tianxiaopeng6666/stm32-/README.md

**项目名称：**
智慧大棚

**项目简介：**
通过二氧化碳传感器实时监测大棚内二氧化碳浓度，判断是否在最适宜大棚内农作物生长区间，通过继电器控制气肥补充；同时加入热释电红外传感器判断大棚内是否有人，降低二氧化碳浓度以免发生危险，最后将数据上传到阿里云，实现可视化。

**项目成员：**
