tianxiaopeng6666/stm32-/第四部分（程序）/注释代码/注释代码/readme.txt

### 适合硬件版本
- 底板：  MCU v1.0
- 传感板：sensor v1.0

### IDE软件
- MDK-ARM Professional 5.34
- 编译器： ARM_Complier_5.06
- ST标准库 V1.8.0 最终版

### 实现功能
- 读取空气中CO2含量和检测人体接近
- 控制继电器开关、风扇、蜂鸣器报警和OLED可视化结果
- 可上电可自动运行，也可以通过微信小程序、阿里云来手动控制继电器开关
