tianxiaopeng6666/stm32-/第四部分（程序）/esp8266程序/数据流转到表格存储.png

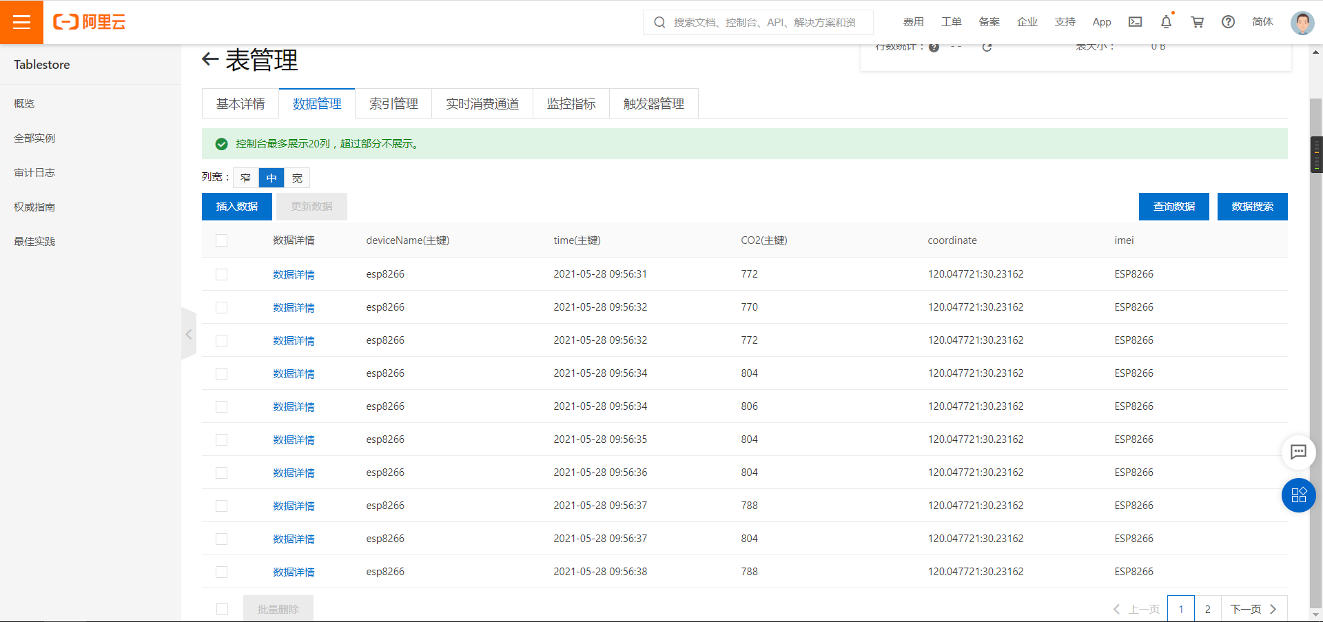
第四部分（程序）/esp8266程序/数据流转到表格存储.png
