tianxiaopeng6666/stm32-/第四部分（程序）/esp8266程序/数据流转规则引擎.png

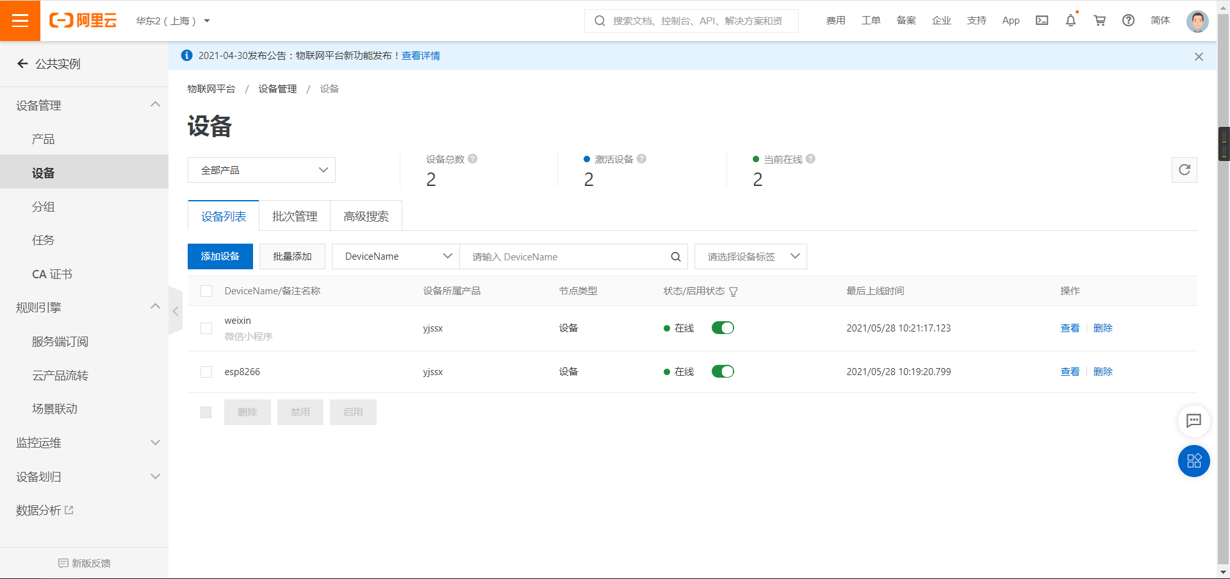
第四部分（程序）/esp8266程序/数据流转规则引擎.png
