tianxiaopeng6666/stm32-/第四部分（程序）/esp8266程序/阿里云ESP8266.png

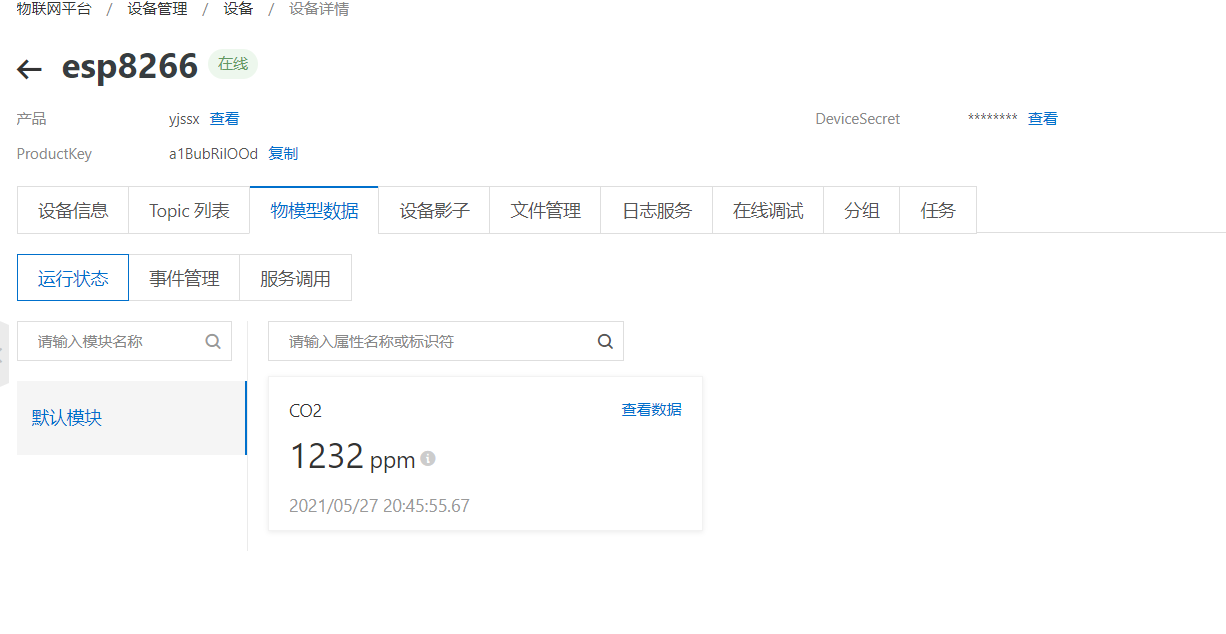
第四部分（程序）/esp8266程序/阿里云ESP8266.png
