tianxiaopeng6666/stm32-/第四部分（程序）/微信小程序图片.png

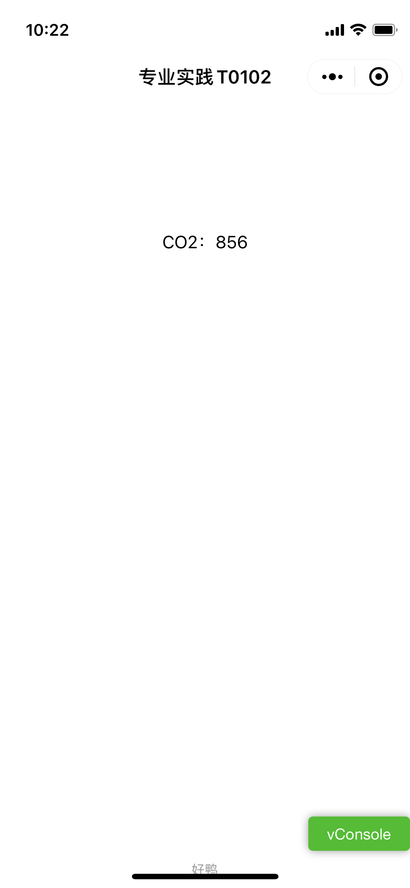
第四部分（程序）/微信小程序图片.png
