tianxiaopeng6666/stm32-/第四部分（程序）/阿里云控制继电器.png

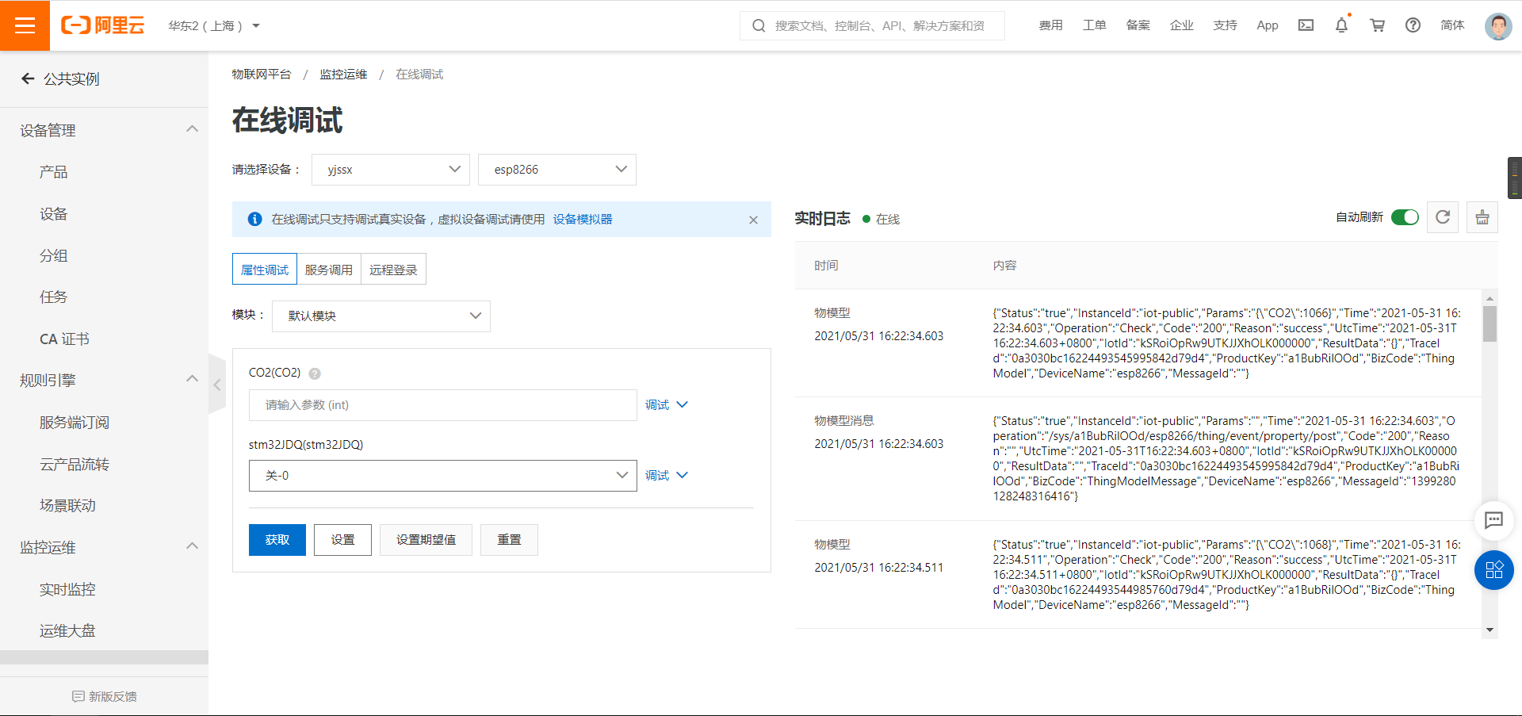
第四部分（程序）/阿里云控制继电器.png
