tianxiaopeng6666/stm32-/第三部分（焊接调试）/硬件调试/README.md

热释红外传感器：v1.0
输出：Voc在人体感应传感器前无人时输出电压为0V，有人时输出电压大于0V

电源模块：v1.0
输出：指示灯亮，万用表连GND与VCC3.3V时，万用表输出3.3V；万用表连GND与VCC5V时，万用表输出5V
