tianxiaopeng6666/stm32-/第三部分（焊接调试）/软件调试/README.md

OLED：V1.0
输出：OLED显示字体图案

蜂鸣器：v1.0
输出：蜂鸣器发出声音

最小系统：v1.0
输出：运行跑马灯程序、LED灯循环亮灭

继电器：v1.0
输出：间隔500ms连通

CO2:v1.0
输出：串口输出二氧化碳含量

热释红外传感器：v1.1
输出：烧入程序，热释红外传感器可通过串口输出是否有人
