tianxiaopeng6666/stm32-/第三部分（焊接调试）/软件调试/esp8266串口通信实验/readme.txt

ESP8266串口通讯实验
8266使用串口三 PD8 PD9  stm32接收串口三的数据
stm32通过串口七 PE7 PE8 将数据转发 
串口调试助手通过串口7可看到 esp8266通过串口三发送的数据
