tianxiaopeng6666/stm32-/第三部分（焊接调试）/软件调试/OLED IIC测试/readme.txt

//  功能描述   : Stm32f427 oled iic 测试程序
//              说明: 
//              ----------------------------------------------------------------
//              GND    电源地
//              VCC    接5V或3.3v电源
//              SCL    接PB10（SCL）
//              SDA    接PB11（SDA）
//              RES    PE14
//              ----------------------------------------------------------------
