tianxiaopeng6666/stm32-/第一部分（调试f411）/调试代码/实验3蜂鸣器实验/README.TXT

实验器材:
	NANO STM32FF4开发板V1版本
	
实验目的:
	进一步学习GPIO作为输出的使用
	
硬件资源:
	1,DS0(连接在PC0) 
	2,蜂鸣器(连接在PB8) 
	
实验现象:
	本实验通过代码控制开发板上的DS0和蜂鸣器，DS0闪烁，提示程序运行，而蜂鸣器
	则周期性的发出“嘀”的声音，间隔为0.3秒。 
	
注意事项:
	无.

					正点原子@ALIENTEK
					2019-3-15
					广州市星翼电子科技有限公司
					电话：020-38271790
					传真：020-36773971
					购买：http://shop62103354.taobao.com
					http://shop62057469.taobao.com
					公司网站：www.alientek.com
					技术论坛：www.openedv.com
