tianxiaopeng6666/stm32-/第三部分（焊接调试）/软件调试/CO2读取测试/readme.txt

CO2读取测试
PA2引脚
TIM5 第三通道
读取高电平时间除周期(1/1khz)为占空比
0-100% 占空比对应0-2000ppm
占空比*20即对应ppm
