tianxiaopeng6666/stm32-/第三部分（焊接调试）/软件调试/Flash_SPI读写测试/readme.txt

flash测试
SPI2
CS   PB12
SCK  PB13
MISO PB14
MOSI PB15
先向flash中写入字符串
然后读取flash串口打印
