tianxiaopeng6666/stm32-/第三部分（焊接调试）/软件调试/串口通信测试/readme.txt

串口调试
调试uart7
RX PE7
TX PE8

在串口监视器看到打印出字符串
