tianxiaopeng6666/stm32-/第三部分（焊接调试）/软件调试/蜂鸣器继电器测试/readme.txt

蜂鸣器 继电器 测试程序
蜂鸣器 PE15
继电器 PE12

蜂鸣器继电器间隔500ms工作
