tianxiaopeng6666/stm32-/第三部分（焊接调试）/硬件调试/晶振起振32.768khz.jpg

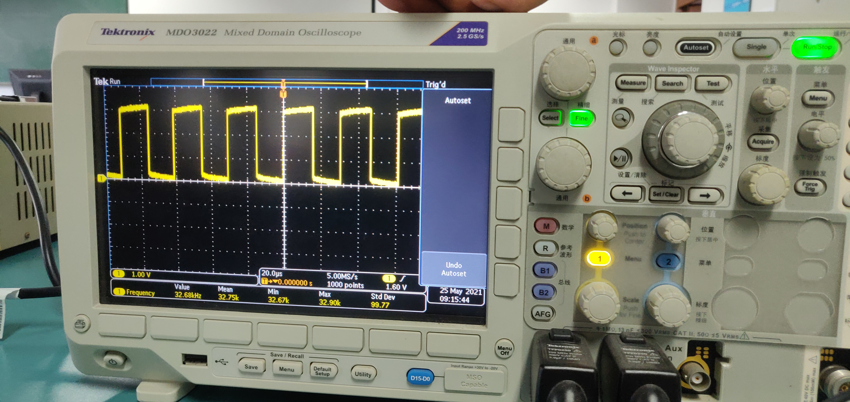
第三部分（焊接调试）/硬件调试/晶振起振32.768khz.jpg
