tianxiaopeng6666/stm32-/第三部分（焊接调试）/硬件调试/热释电红外传感器无人.jpg

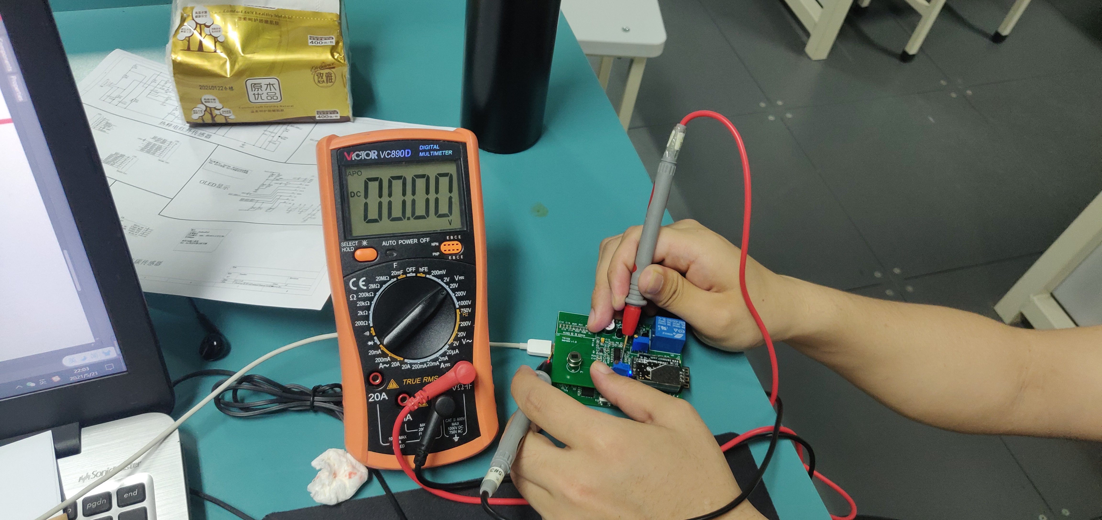
第三部分（焊接调试）/硬件调试/热释电红外传感器无人.jpg
