tianxiaopeng6666/stm32-/第三部分（焊接调试）/硬件调试/电源调试5V.jpg

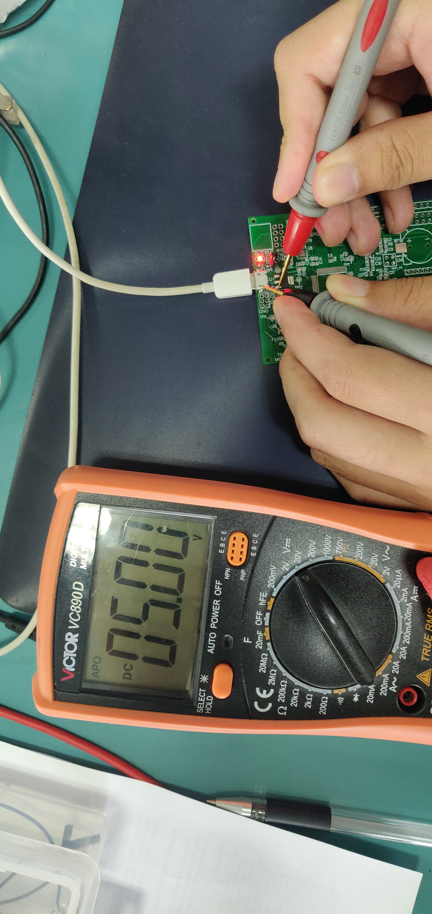
第三部分（焊接调试）/硬件调试/电源调试5V.jpg
