tianxiaopeng6666/stm32-/第三部分（焊接调试）/软件调试/CO2调试图片.jpg

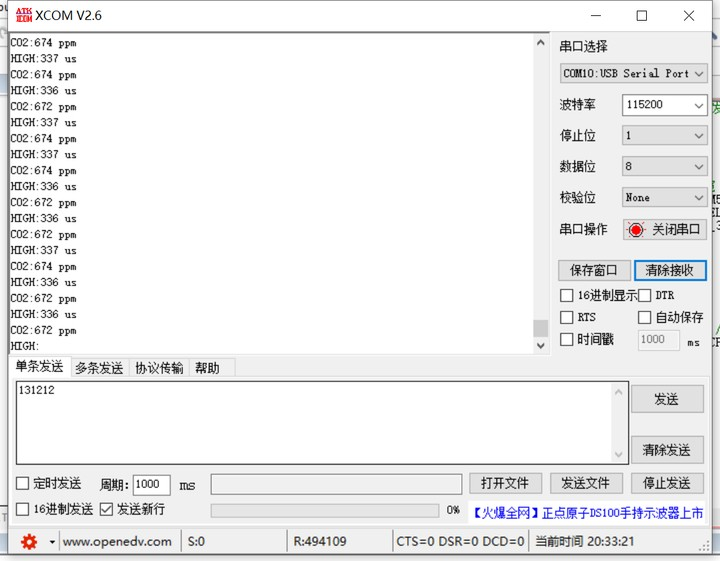
第三部分（焊接调试）/软件调试/CO2调试图片.jpg
