tianxiaopeng6666/stm32-/第三部分（焊接调试）/软件调试/DS3231测试.jpg

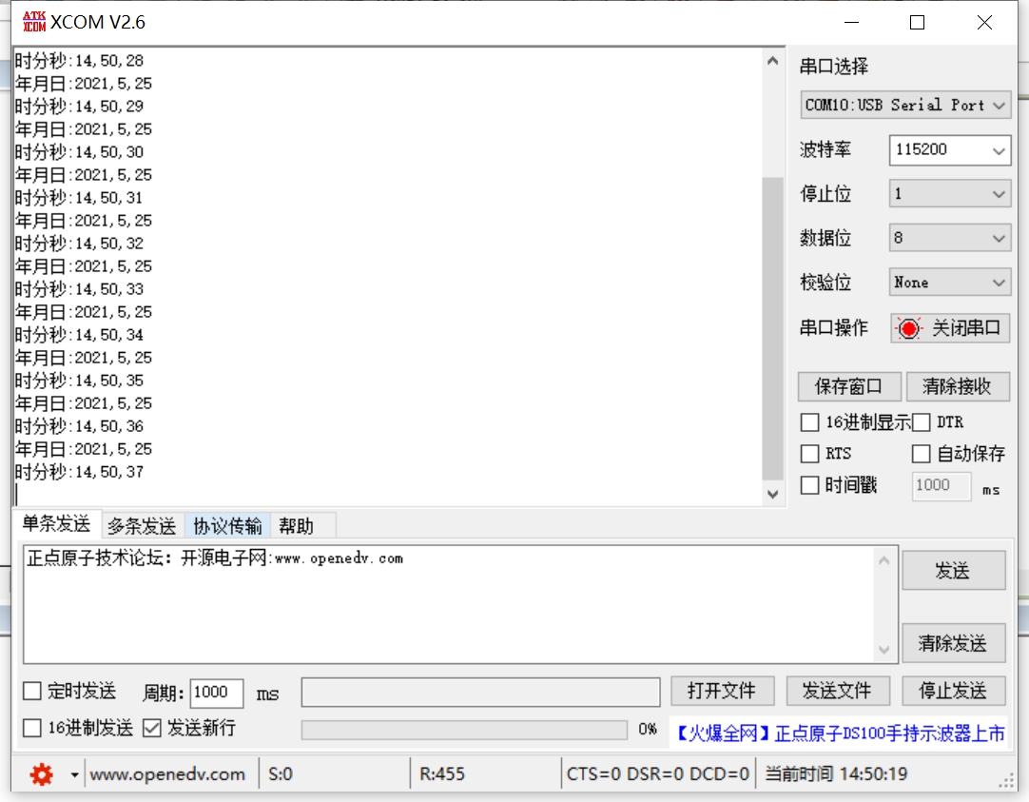
第三部分（焊接调试）/软件调试/DS3231测试.jpg
