tianxiaopeng6666/stm32-/第三部分（焊接调试）/软件调试/esp8266串口实验.png

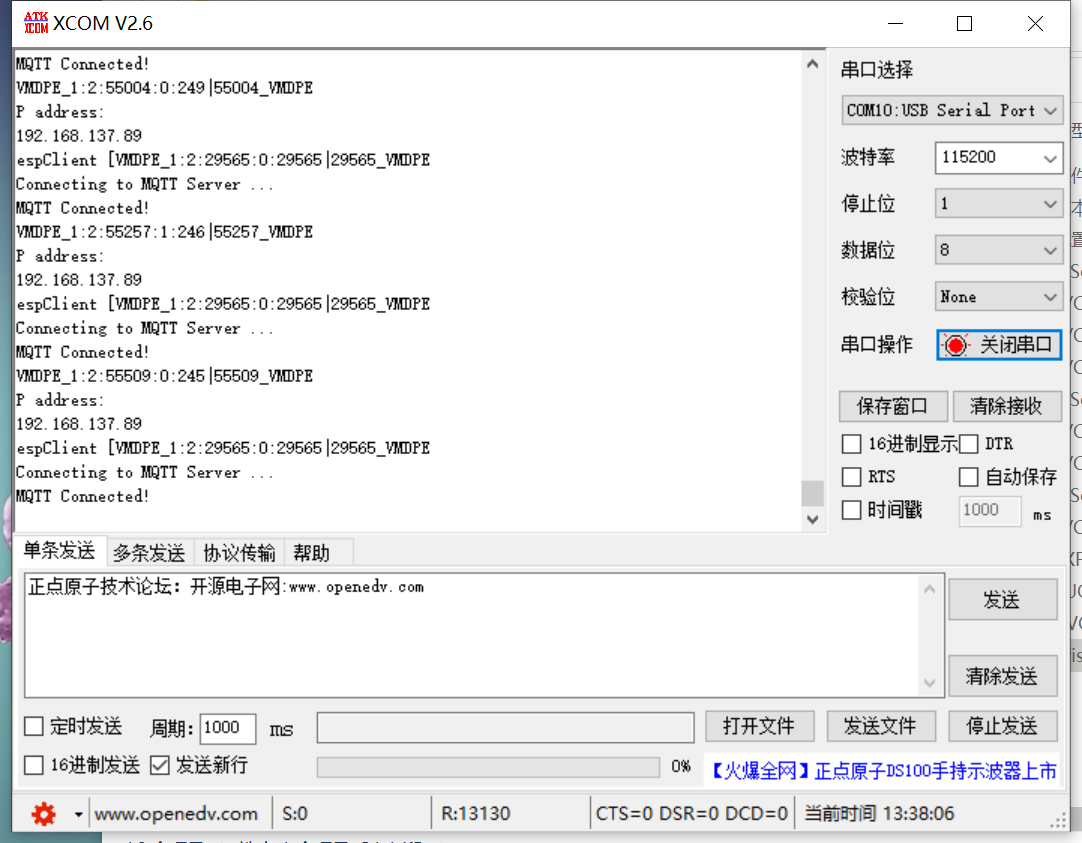
第三部分（焊接调试）/软件调试/esp8266串口实验.png
