tianxiaopeng6666/stm32-/第三部分（焊接调试）/软件调试/Flash_SPI读写测试.png

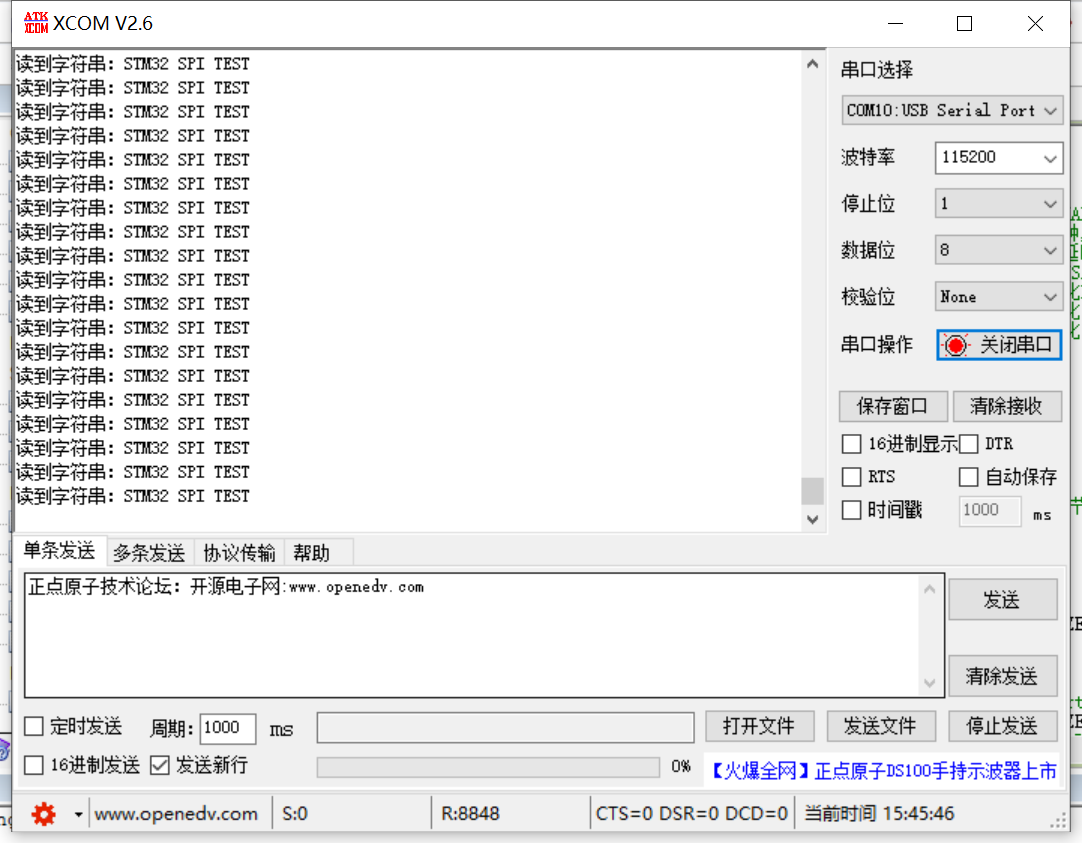
第三部分（焊接调试）/软件调试/Flash_SPI读写测试.png
