tianxiaopeng6666/stm32-/第三部分（焊接调试）/软件调试/OLED焊接的新底板F427上测试.jpg

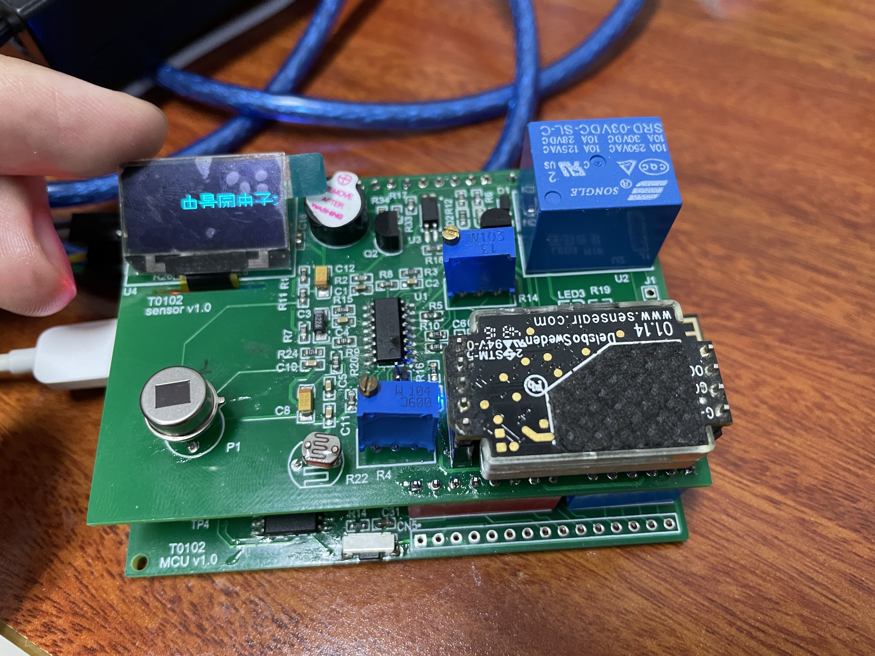
第三部分（焊接调试）/软件调试/OLED焊接的新底板F427上测试.jpg
