tianxiaopeng6666/stm32-/第三部分（焊接调试）/软件调试/串口测试.jpg

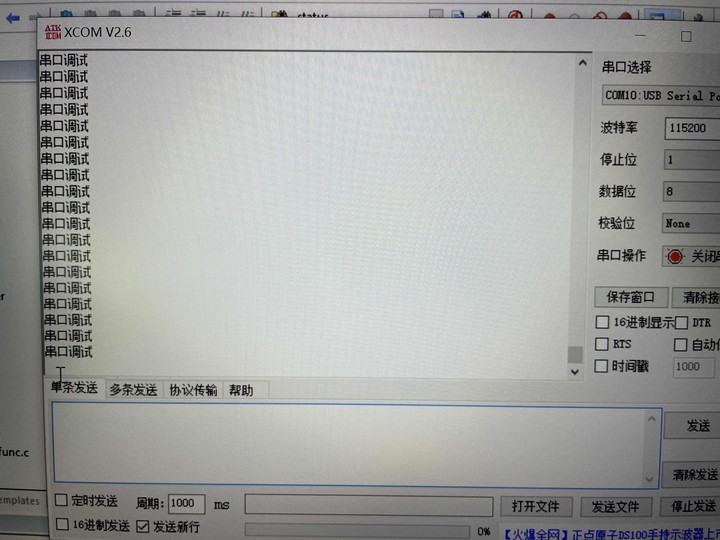
第三部分（焊接调试）/软件调试/串口测试.jpg
