tianxiaopeng6666/stm32-/第三部分（焊接调试）/软件调试/最小系统调试程序运行灯亮.jpg

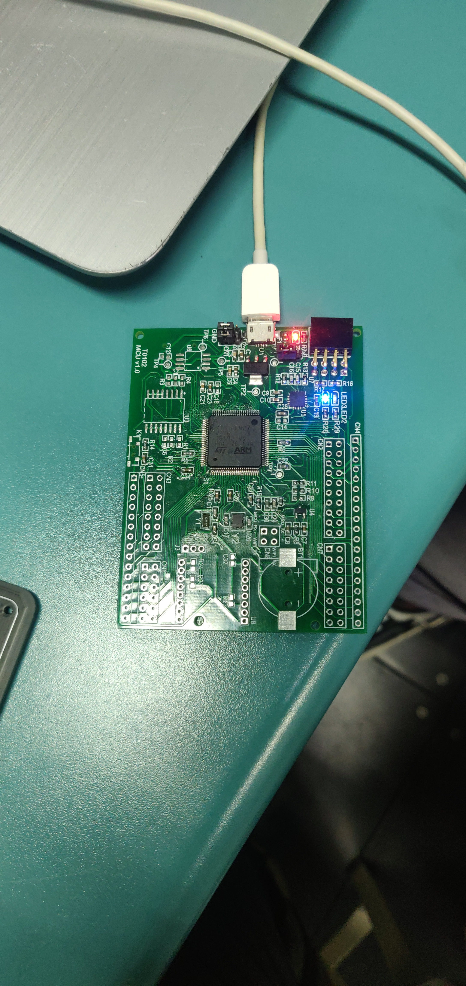
第三部分（焊接调试）/软件调试/最小系统调试程序运行灯亮.jpg
