tianxiaopeng6666/stm32-/(list of files, drawings)

Other design files:
第二部分（原理图与PCB）/传感器板/Sensor.PcbDoc
第二部分（原理图与PCB）/传感器板/Sensor.PcbLib
第二部分（原理图与PCB）/传感器板/sensor.PrjPcb
第二部分（原理图与PCB）/传感器板/Sensor.SchDoc
第二部分（原理图与PCB）/传感器板/sensor.SCHLIB
第二部分（原理图与PCB）/底板/chip.PcbDoc
第二部分（原理图与PCB）/底板/chip.PcbLib
第二部分（原理图与PCB）/底板/chip.PrjPcb
第二部分（原理图与PCB）/底板/chip.SchDoc
第二部分（原理图与PCB）/底板/chip.SCHLIB
