tianxiaopeng6666/stm32-/第一部分（调试f411）/调试代码/实验1跑马灯测试/SYSTEM/usart/usart.h

#ifndef __USART_H
#define __USART_H
#include "stdio.h"	
#include "sys.h" 
//////////////////////////////////////////////////////////////////////////////////	 
//本程序只供学习使用，未经作者许可，不得用于其它任何用途
//ALIENTEK STM32F429开发板
//串口1初始化		   
//正点原子@ALIENTEK
//技术论坛:www.openedv.csom
//修改日期:2015/6/23
//版本：V1.0
//版权所有，盗版必究。
//Copyright(C) 正点原子 2009-2019
//All rights reserved
//********************************************************************************
//V1.0修改说明 
////////////////////////////////////////////////////////////////////////////////// 	
#define USART_REC_LEN  			200  	//定义最大接收字节数 200
#define EN_USART1_RX 			1		//使能（1）/禁止（0）串口1接收
	  	
extern u8  USART_RX_BUF[USART_REC_LEN]; //接收缓冲,最大USART_REC_LEN个字节.末字节为换行符 
extern u16 USART_RX_STA;         		//接收状态标记	
extern UART_HandleTypeDef UART1_Handler; //UART句柄

#define RXBUFFERSIZE   1 //缓存大小
extern u8 aRxBuffer[RXBUFFERSIZE];//HAL库USART接收Buffer

//如果想串口中断接收，请不要注释以下宏定义
void uart_init(u32 bound);
#endif
