tianxiaopeng6666/stm32-/第三部分（焊接调试）/软件调试/CO2读取测试/HARDWARE/TIMER/timer.h

#ifndef __PWM_H
#define __PWM_H
#include "sys.h"

extern TIM_HandleTypeDef TIM3_Handler;      //定时器3PWM句柄 
extern TIM_OC_InitTypeDef TIM3_CH4Handler;  //定时器3通道4句柄
extern TIM_HandleTypeDef TIM5_Handler;      //定时器5句柄

void TIM3_Init(u16 arr,u16 psc);
void TIM3_PWM_Init(u16 arr,u16 psc);
void TIM_SetTIM3Compare4(u32 compare);
u32 TIM_GetTIM3Capture4(void);
void TIM5_CH3_Cap_Init(u32 arr,u16 psc);
#endif
