tianxiaopeng6666/stm32-/(commit log)

2021-07-10 删除 焊接与调试任务细分.doc
2021-07-11 删除 需求报告.docx
