tianxiaopeng6666/stm32-/(notices)

Notices in the files:
第三部分（焊接调试）/软件调试/CO2读取测试/HARDWARE/KEY/key.c:
Copyright(C) ¹ãÖÝÊÐÐÇÒíµç×Ó¿Æ¼¼ÓÐÏÞ¹«Ë¾ 2014-2024
All rights reserved
第一部分（调试f411）/调试代码/实验1跑马灯测试/SYSTEM/usart/usart.h:
Copyright(C) ÕýµãÔ­×Ó 2009-2019
第一部分（调试f411）/调试代码/实验2串口通信实验/HARDWARE/KEY/key.c:
Copyright(C) ¹ãÖÝÊÐÐÇÒíµç×Ó¿Æ¼¼ÓÐÏÞ¹«Ë¾ 2019-2029
第三部分（焊接调试）/软件调试/esp8266串口通信实验/SYSTEM/usart/usart.c:
Copyright(C) ¹ãÖÝÊÐÐÇÒíµç×Ó¿Æ¼¼ÓÐÏÞ¹«Ë¾ 2009-2019
